Picatout/tubular-door-bell/docs/Grand_pic-f1.jpg

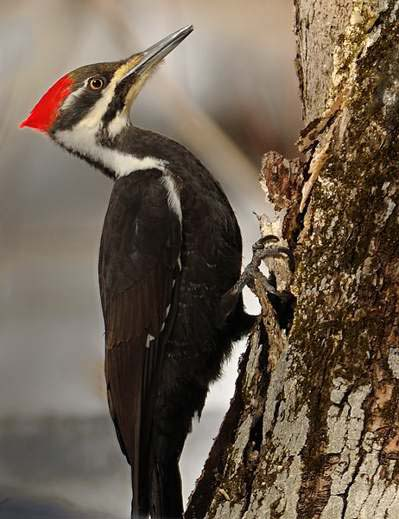
docs/Grand_pic-f1.jpg
