Picatout/tubular-door-bell/docs/DIY_Millimeters_Wind_Chime_Tube_Calculator_A440_C9_Chord.ods

Sheet: Tubing Length Calculator
Chime Length Calculator for the C-9 Chord (C E G Bb D) mm version A=440 for a Tube or Rod unrestricted at both ends
To determine the resonant frequency for a rod set the ID=0 and enter the OD and Metal Type
Enter values in BLUE, answers in ORANGE (inches) and in YELLOW (mm)
OD mm = |  | 15,312 | ID mm = |  | 12,208 | Metal = |  | Copper |  | < Click to Select
Wall = | 1,552 | mm | Length calculated for fundamental F Hang Point is for fundamental F node
Note | Freq Hz | Length inches | Hang Point | Length mm | Hang Point | Note | Freq Hz | Length inches | Hang Point | Length mm | Hang Point
C1 | 32,70 | 53 7/8 | 12 1/16 | 1368,4 | 306,8 | C5 | 523,30 | 13 1/2 | 3 | 342,9 | 76,9
E | 41,21 | 48 | 10 3/4 | 1219,2 | 273,3 | E | 659,30 | 12 | 2 11/16 | 304,8 | 68,3
G | 49,00 | 44 1/16 | 9 7/8 | 1119,2 | 250,9 | G | 784,00 | 11 | 2 7/16 | 279,4 | 62,6
A#/Bb | 58,30 | 40 3/8 | 9 1/16 | 1025,5 | 229,9 | A#/Bb | 932,30 | 10 1/8 | 2 1/4 | 257,2 | 57,7
D2 | 73,41 | 36 | 8 1/16 | 914,4 | 205,0 | D6 | 1 174,61 | 9 | 2 | 228,6 | 51,3
Total feet = |  | 18,5 | Total cm= | 564,7 |  | Total feet required |  | 4,6 | Total cm= | 141,3
C2 | 65,40 | 38 1/8 | 8 9/16 | 968,4 | 217,1 | C6 | 1 046,50 | 9 1/2 | 2 1/8 | 241,3 | 54,1
E | 82,40 | 33 15/16 | 7 5/8 | 862,0 | 193,3 | E | 1 318,50 | 8 1/2 | 1 7/8 | 215,9 | 48,4
G | 98,01 | 31 1/8 | 7 | 790,6 | 177,2 | G | 1 568,00 | 7 13/16 | 1 3/4 | 198,4 | 44,5
A#/Bb | 116,50 | 28 9/16 | 6 3/8 | 725,5 | 162,7 | A#/Bb | 1 864,60 | 7 1/8 | 1 5/8 | 181,0 | 40,6
D3 | 146,80 | 25 7/16 | 5 11/16 | 646,1 | 144,9 | D7 | 2 349,20 | 6 3/8 | 1 7/16 | 161,9 | 36,3
Total feet required |  | 13,1 | Total cm= | 399,3 |  | Total feet required |  | 3,3 | Total cm= | 99,9
C3 | 130,81 | 26 15/16 | 6 1/16 | 684,2 | 153,4 | C7 | 2 093,00 | 6 3/4 | 1 1/2 | 171,5 | 38,4
E | 164,80 | 24 | 5 3/8 | 609,6 | 136,7 | E | 2 637,00 | 6 | 1 3/8 | 152,4 | 34,2
G | 196,00 | 22 | 4 15/16 | 558,8 | 125,3 | G | 3 136,00 | 5 1/2 | 1 1/4 | 139,7 | 31,3
A#/Bb | 233,10 | 20 3/16 | 4 1/2 | 512,8 | 115,0 | A#/Bb | 3 729,20 | 5 1/16 | 1 1/8 | 128,6 | 28,8
D4 | 293,70 | 18 | 4 1/16 | 457,2 | 102,5 | D8 | 4 698,40 | 4 1/2 | 1 | 114,3 | 25,6
Total feet required |  | 9,3 | Total cm= | 282,3 |  | Total feet required |  | 2,3 | Total cm= | 70,6
C4 | 261,60 | 19 1/16 | 4 1/4 | 484,2 | 108,6
E | 329,61 | 17 | 3 13/16 | 431,8 | 96,8
G | 392,00 | 15 9/16 | 3 1/2 | 395,3 | 88,6
A#/Bb | 466,20 | 14 1/4 | 3 3/16 | 362,0 | 81,1
D5 | 587,30 | 12 3/4 | 2 7/8 | 323,9 | 72,6
Total feet required |  | 6,6 | Total cm= | 199,7
Calculate Length or Frequency for ID & OD entered above
Enter F= | 220,00 | 20 13/16 | 4 11/16 | 528,6 | 118,5 | Convert |  | 2,000 | inches to | 50,8 | mm
 |  | Enter L ↓ |  |  |  |  |  | 25,4 | mm to | 1 | inches
F= | 204,35 | 21 9/16 | 4 13/16 | 547,7 | 122,8 | http://leehite.org/Chimes.htm

Sheet: Tubing Length Ratio Calculator
Wind Chime Tubing Length Ratio Calculator
Can be used for a tube open at both ends or for a tube with end caps
 |  | by referencing a tube of known length & frequency.
Enter Values in Blue Boxes Answers in Green Boxes
Enter measured tubing length | Enter measured tubing frequency | Enter desired tubing frequency | Answer length of tubing for desired frequency | Answer Hang point for tube open at both ends
mm or Inches | Hz | Hz
18,25 | 440,0 | 392 | 19 5/16 | 4 5/16
If you have a chime tube for which you know the exact musical note or the exact frequency, you can use that tube to make other chimes in the same family of size and metal. The tube does not need to match any particular note or frequency. The important measurement is that you know the exact frequency and length. For example, say you have a 3/4" type L copper pipe that you know is tuned for A4 (440 Hz) and it's length is 18 1/4" inches, and you want a tube tuned for 392 Hz. Enter those values in the blue boxes. The green boxes provide the length for the 392 Hz chime and the hang point at 4 5/16". Repeating the process until you have determined the correct length for all the chimes in your set. You then have lengths for notes using 3/4" type L copper pipe. If you do not know the musical note or frequency for a length of tubing, use a piano or other musical instrument to determine the musical note. Maybe ask a musical friend to help out. A good piano tuning program called Tune Lab Pro works well for measuring frequency. Do not use it for measuring musical notes as it is set up for a string instrument and not for a wind chime tube, but it will tell you the fundamental frequency.
See | www.tunelab-world.com/

Sheet: DATA
February 20, 2010 | Properties Used for Calculations
Modulus of Elasticity = | 16 000 000 | psi
Density = | 0,3226 | Lbm / in3
Constants
Gravity Constant = | 386,4 | In / sec2
Euler's Constants = | βl2 | Suspension Point
1st = | 22,370 | 0,2242
2nd = | 61,670 | 0,132
3rd = | 120,900 | 0,0944
4th = | 199,859 | 0,0735
Calculate Values
Area Moment of Inertia = | 0,003863333246796 | in4
Area = | 0,103990242336149 | in2
K =√ ( E*I / (A*p) ) = | 26682,7851506265
 | Material Properties
 | Modulus of Elasticity | Density
Material | psi | Lbm / in3 | Adjust Modulus of Elasticity and Density to fit your specific material of choice.
Aluminum | 10 000 000 | 0,0980
Brass | 17 000 000 | 0,3080
Cast Iron | 13 400 000 | 0,2600
Copper | 16 000 000 | 0,3226
Steel | 30 000 000 | 0,2835
Stainless Steel | 28 300 000 | 0,2830
Titanium | 14 900 000 | 0,1630
 | Nominal Values | Nominal Values
Aluminum | 10,000,000 to 10,300,000 | 0.0925 to 0.098
Brass | 15,000,000 to 17,000,000 | 0.303 to 0.315
Cast Iron | 11,600,000 to 13,400,000 | 0.2456 to 0.2817
Copper | 16,000,000 to 17,000,000 | 0,3226
Steel | 30 000 000 | 0,2835
Stainless Steel | 28,000,000 to 29,000,000 | 0.2702 to 0.2889
Titanium | 14,500,000 to 14,900,000 | 0.162 to 0.164
All dimensions calculated are based on OD, ID in mm and Material type OD = outside dimension of tubing (mm), ID = inside dimension of tubing (mm) Material type = Aluminum, Brass, Cast Iron, Copper, Steel, Stainless Stee and Titanium Note selection by frequency in Hz. The calculator uses nominal values for material properties; however, if you know the exact material density and the exact modulus of elasticity, you can enter that data for your specific material.
Be aware that some tubing may produce a beating effect when struck. This is often due to variations in the cross section of the tubing from variations and inconsistencies in the manufacturing process. The Elasticity and the Density of the tubing will be different depending on where the tube is struck. The tube will produce two frequencies and these two frequencies will produce the beating effect. Some people enjoy this type of effect, others may find it annoying. If you want to avoid this wah-wah effect, make sure you acquire high quality tubing – or test a small piece before buying in bulk. The problem with tubing which exhibits this type of effect is that it makes precise tuning more difficult.

Sheet: Music Scale
Note | A=440 Freq Hz | 1st Overtone X 2.76 | 2nd Overtone X 5.40 | 3rd Overtone X 8.93 | 4th Overtone X 13.34 | Note | Freq Hz | 1st Overtone X 2.76 | 2nd Overtone X 5.40 | 3rd Overtone X 8.93 | 4th Overtone X 13.34
C0 | 16,40 | 45,18 | 88,56 | 146,45 | 218,78 | G | 392,00 | 1 079,96 | 2 116,80 | 3 500,56 | 5 229,28
C#/Db | 17,30 | 17,30 | 93,42 | 154,49 | 230,78 | G#/Ab | 415,30 | 1 144,15 | 2 242,62 | 3 708,63 | 5 540,10
D | 18,40 | 50,69 | 99,36 | 164,31 | 245,46 | A | 440,01 | 1 212,23 | 2 376,05 | 3 929,29 | 5 869,73
D#/Eb | 19,40 | 53,45 | 104,76 | 173,24 | 258,80 | A#/Bb | 466,20 | 1 284,38 | 2 517,48 | 4 163,17 | 6 219,11
E | 20,60 | 56,75 | 111,24 | 183,96 | 274,80 | B | 493,91 | 1 360,72 | 2 667,11 | 4 410,62 | 6 588,76
F | 21,80 | 60,06 | 117,72 | 194,67 | 290,81 | C5 | 523,30 | 1 441,69 | 2 825,82 | 4 673,07 | 6 980,82
F#/Gb | 23,10 | 63,64 | 124,74 | 206,28 | 308,15 | C#/Db | 554,40 | 1 527,37 | 2 993,76 | 4 950,79 | 7 395,70
G | 24,50 | 67,50 | 132,30 | 218,79 | 326,83 | D | 587,30 | 1 618,01 | 3 171,42 | 5 244,59 | 7 834,58
G#/Ab | 26,00 | 71,63 | 140,40 | 232,18 | 346,84 | D#/Eb | 622,30 | 1 714,44 | 3 360,42 | 5 557,14 | 8 301,48
A | 27,50 | 75,76 | 148,50 | 245,58 | 366,85 | E | 659,30 | 1 816,37 | 3 560,22 | 5 887,55 | 8 795,06
A#/Bb | 29,10 | 80,17 | 157,14 | 259,86 | 388,19 | F | 698,50 | 1 924,37 | 3 771,90 | 6 237,61 | 9 317,99
B | 30,90 | 85,13 | 166,86 | 275,94 | 412,21 | F#/Gb | 740,00 | 2 038,70 | 3 996,00 | 6 608,20 | 9 871,60
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
C4 | 261,60 | 720,71 | 1 412,64 | 2 336,09 | 3 489,74 | G | 6 272,00 | 17 279,36 | 33 868,80 | 56 008,96 | 83 668,48
C#/Db | 277,20 | 763,69 | 1 496,88 | 2 475,40 | 3 697,85 | G#/Ab | 6 644,80 | 18 306,42 | 35 881,92 | 59 338,06 | 88 641,63
D | 293,70 | 809,14 | 1 585,98 | 2 622,74 | 3 917,96 | A | 7 040,00 | 19 395,20 | 38 016,00 | 62 867,20 | 93 913,60
D#/Eb | 311,10 | 857,08 | 1 679,94 | 2 778,12 | 4 150,07 | A#/Bb | 7 458,40 | 20 547,89 | 40 275,36 | 66 603,51 | 99 495,06
E | 329,61 | 908,08 | 1 779,89 | 2 943,42 | 4 397,00 | B | 7 902,01 | 21 770,04 | 42 670,85 | 70 564,95 | 105 412,81
F | 349,30 | 962,32 | 1 886,22 | 3 119,25 | 4 659,66 | C9 | 8 367,01 | 23 051,11 | 45 181,85 | 74 717,40 | 111 615,91
F#/Gb | 370,00 | 1 019,35 | 1 998,00 | 3 304,10 | 4 935,80

Sheet: Aluminum
Standard Dimension Tables for Aluminum Tubing (inches)
Tubing Gauge | 22 | 20 | 18 | 17 | 16 | 14 | 12
Wall Thickness | 0,028 | 0,035 | 0,049 | 0,058 | 0,065 | 0,083 | 0,109
* These sizes are extruded; all other sizes are drawn tubes.
OD inches | ID inches | Wall inches | OD inches | ID inches | Wall inches | OD inches | ID inches | Wall inches
0,500 | 0,444 | 0,028 | 1,000 | 0,930 | 0,035 | 1,625 | 1,555 | 0,035
 | 0,430 | 0,035 |  | 0,902 | 0,049 |  | 1,509 | 0,058
 | 0,402 | 0,049 |  | 0,884 | 0,058 | 1,750 | 1,634 | 0,058
 | 0,384 | 0,058 |  | 0,870 | 0,065 |  | 1,584 | 0,083
 | 0,370 | 0,065 |  | 0,834 | 0,083 | 1,875 | 1,759 | 0,508
0,625 | 0,569 | 0,028 | 1,125 | 1,055 | 0,035 | 2,000 | 1,902 | 0,049
 | 0,555 | 0,035 |  | 1,009 | 0,058 |  | 1,870 | 0,065
 | 0,527 | 0,049 | 1,250 | 1,180 | 0,035 |  | 1,834 | 0,083
 | 0,509 | 0,058 |  | 1,152 | 0,049 |  | 1,750 | *0.125
 | 0,495 | 0,065 |  | 1,134 | 0,058 |  | 1,500 | *0.250
0,750 | 0,680 | 0,035 |  | 1,120 | 0,065 | 2,250 | 2,152 | 0,049
 | 0,652 | 0,049 |  | 1,084 | 0,083 |  | 2,120 | 0,065
 | 0,634 | 0,058 | 1,375 | 1,305 | 0,035 |  | 2,084 | 0,083
 | 0,620 | 0,065 |  | 1,259 | 0,058 | 2,500 | 2,370 | 0,065
 | 0,584 | 0,083 | 1,500 | 1,430 | 0,035 |  | 2,334 | 0,083
0,875 | 0,805 | 0,035 |  | 1,402 | 0,049 |  | 2,250 | *0.125
 | 0,777 | 0,049 |  | 1,384 | 0,058 |  | 2,000 | *0.250
 | 0,759 | 0,058 |  | 1,370 | 0,065 | 3,000 | 2,870 | 0,065
 | 0,745 | 0,065 |  | 1,334 | 0,083 |  | 2,750 | *0.125
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
 |  |  | 5" OD x 0.25" WALL x 4.5" ID
 |  |  | 6" OD x 0.125" WALL x 5.75" ID
 |  |  | 6" OD x 0.1875" WALL x 5.625" ID
 |  |  | 7" OD x 0.125" WALL x 6.75" ID
 |  |  | 8" OD x 0.125" WALL x 7.75" ID
 |  |  | 8" OD x 0.25" WALL x 7.5" ID
 |  |  | 8" OD x 0.5" WALL x 7" ID

Sheet: Brass
Standard Dimension Tables for Brass
Available sizes for Tube Brass | Available sizes for BRASS TUBE
1/2" OD {A} x 0.436" ID {B} x .032" Wall | 0.5" OD x 0.03" WALL x 0.44" ID
1/2" OD {A} x 0.370" ID {B} x .065" Wall | 0.5" OD x 0.042" WALL x 0.416" ID
5/8" OD {A} x 0.561" ID {B} x .032" Wall | 0.5" OD x 0.065" WALL x 0.37" ID
5/8" OD {A} x 0.495" ID {B} x .065" Wall | 0.625" OD x 0.029" WALL x 0.567" ID
3/4" OD {A} x 0.686" ID {B} x .032" Wall | 0.625" OD x 0.065" WALL x 0.495" ID
3/4" OD {A} x 0.620" ID {B} x .065" Wall | 0.75" OD x 0.029" WALL x 0.692" ID
1" OD {A} x 0.870" ID {B} x .065" Wall | 0.75" OD x 0.04" WALL x 0.67" ID
1-1/4" OD {A} x 1.120" ID {B} x .065" Wall | 0.75" OD x 0.065" WALL x 0.62" ID C330 TUBE
1-1/2" OD {A} x 1.370" ID {B} x .065" Wall | 0.75" OD x 0.12" WALL x 0.51" ID
1-1/2" OD {A} x 1.250" ID {B} x .125" Wall | 0.875" OD x 0.03" WALL x 0.815" ID
1-5/8" OD {A} x 1.375" ID {B} x .125" Wall | 0.875" OD x 0.065" WALL x 0.745" ID
1-3/4" OD {A} x 1.620" ID {B} x .065" Wall | 1" OD x 0.03" WALL x 0.94" ID
2" OD {A} x 1.870" ID {B} x .065" Wall | 1" OD x 0.065" WALL x 0.87" ID
2-1/4" OD {A} x 2.120" ID {B} x .065" Wall | 1.25" OD x 0.04" WALL x 1.17" ID
 | 1.25" OD x 0.065" WALL x 1.12" ID
 | 1.5" OD x 0.04" WALL x 1.42" ID
 | 1.5" OD x 0.065" WALL x 1.37" ID
 | 1.75" OD x 0.065" WALL x 1.62" ID
 | 1.75" OD x 0.12" WALL x 1.51" ID
 | 2" OD x 0.049" WALL x 1.902" ID
 | 2" OD x 0.065" WALL x 1.87" ID
 | 2" OD x 0.109" WALL x 1.782" ID
 | 2" OD x 0.12" WALL x 1.76" ID
 | 2.5" OD x 0.065" WALL x 2.37" ID
 | 3" OD x 0.049" WALL x 2.902" ID
 | 3" OD x 0.065" WALL x 2.87" ID
 | 4" OD x 0.065" WALL x 3.87" ID C330 TUBE

Sheet: Copper
Standard Dimension Tables for Copper Tubing
Wall thickness of copper pipe varies with the pipe schedule. The four common standards are named K (Thick-Walled), L (Medium-Walled), M (Thin-Wall), and DWV (Drain/Waste/Vent - non-pressurized) The printing on the pipe is color coded for identification; K is Green, L is Blue, M is Red, and DWV is Yellow. Both type "M" & type "L" can be found in home plumbing at Home Depot & Lowes.
Nominal | Actual O.D. | I.D. |  |  |  | Wall Thickness
Pipe Size |  | K | L | M | DWV | K | L | M | DWV
1/2" | 0,625 | 0,527 | 0,545 | 0,569 | - | 0,049 | 0,04 | 0,028 | -
5/8" | 0,750 | 0,652 | 0,666 | - | - | 0,049 | 0,042 | - | -
3/4" | 0,875 | 0,745 | 0,785 | 0,811 | - | 0,065 | 0,045 | 0,032 | -
1" | 1,125 | 0,995 | 1,025 | 1,055 | - | 0,065 | 0,05 | 0,035 | -
1-1/4" | 1,375 | 1,245 | 1,265 | 1,291 | 1,295 | 0,065 | 0,055 | 0,042 | 0,04
1-1/2" | 1,625 | 1,481 | 1,505 | 1,527 | 1,541 | 0,072 | 0,06 | 0,049 | 0,042
2" | 2,125 | 1,959 | 1,985 | 2,009 | 2,041 | 0,083 | 0,07 | 0,058 | 0,042
2-1/2" | 2,625 | 2,435 | 2,465 | 2,495 | - | 0,095 | 0,08 | 0,065 | -
3" | 3,125 | 2,907 | 2,945 | 2,981 | 3,03 | 0,109 | 0,09 | 0,072 | 0,045
3 1/2 | 3,625 | 3,385 | 3,425 | 3,259 |  | 0,12 | 0,1 | 0,083
4 | 4,125 | 3,857 | 3,897 | 3,707 |  | 0,134 | 0,114 | 0,095
5 | 5,125 | 4,805 | 4,875 | 4,657 |  | 0,16 | 0,125 | 0,109
6 | 6,125 | 5,741 | 5,845 | 5,601 |  | 0,192 | 0,14 | 0,122
Available sizes for |  |  |  |  | Available sizes for
C101 H04 (FULL HARD) TUBE |  |  |  |  | C122 HARD DRAWN TUBE
0.5" OD x 0.035" WALL x 0.43" ID |  |  |  |  | 0.5" OD x 0.032" WALL x 0.436" ID
0.5" OD x 0.0625" WALL x 0.375" ID |  |  |  |  | 0.5" OD x 0.065" WALL x 0.37" ID
0.5" OD x 0.125" WALL x 0.25" ID |  |  |  |  | 0.625" OD x 0.065" WALL x 0.495" ID
0.625" OD x 0.121" WALL x 0.383" ID |  |  |  |  | 0.75" OD x 0.065" WALL x 0.62" ID
0.75" OD x 0.035" WALL x 0.68" ID |  |  |  |  | 0.875" OD x 0.065" WALL x 0.745" ID
0.75" OD x 0.0625" WALL x 0.625" ID |  |  |  |  | 1" OD x 0.065" WALL x 0.87" ID
0.75" OD x 0.125" WALL x 0.5" ID |  |  |  |  | 1.25" OD x 0.065" WALL x 1.12" ID
1" OD x 0.125" WALL x 0.75" ID |  |  |  |  | 1.5" OD x 0.065" WALL x 1.37" ID
1" OD x 0.25" WALL x 0.5" ID |  |  |  |  | 2" OD x 0.065" WALL x 1.87" ID
1.25" OD x 0.125" WALL x 1" ID
1.5" OD x 0.125" WALL x 1.25" ID
1.5" OD x 0.25" WALL x 1" ID
1.5" OD x 0.375" WALL x 0.75" ID
1.625" OD x 0.049" WALL x 1.527" ID
1.75" OD x 0.065" WALL x 1.62" ID
1.75" OD x 0.375" WALL x 1" ID
2" OD x 0.063" WALL x 1.874" ID
2" OD x 0.125" WALL x 1.75" ID
2.125" OD x 0.25" WALL x 1.625" ID
2.25" OD x 0.3125" WALL x 1.625" ID
2.5" OD x 0.065" WALL x 2.37" ID
2.5" OD x 0.25" WALL x 2" ID
2.5" OD x 0.375" WALL x 1.75" ID
2.75" OD x 0.25" WALL x 2.25" ID
2.75" OD x 0.375" WALL x 2" ID
2.75" OD x 0.625" WALL x 1.5" ID
3" OD x 0.25" WALL x 2.5" ID
3" OD x 0.625" WALL x 1.75" ID
3.5" OD x 0.062" WALL x 3.376" ID
3.5" OD x 0.187" WALL x 3.126" ID
3.5" OD x 0.25" WALL x 3" ID
3.5" OD x 0.562" WALL x 2.376" ID
3.75" OD x 0.5" WALL x 2.75" ID
4" OD x 0.25" WALL x 3.5" ID
4" OD x 0.5" WALL x 3" ID
4" OD x 0.625" WALL x 2.75" ID
4.5" OD x 0.109" WALL x 4.282" ID
6.5" OD x 0.5" WALL x 5.5" ID
7.5" OD x 0.125" WALL x 7.25" ID

Sheet: Iron
Standard Dimension Tables for Iron
Pipe is specified by a nominal dimension which bears little or no resemblance to the actual dimensions of the pipe.
Wrought Iron Pipe (Schedule 40) is used for water supply in older houses. It comes either black or galvanized. Joints are made by threading pipe into cast iron fittings
Nominal Pipe Size inches | O.D. | I.D. | Wall
 |  |  | Thickness
1 | 1,315 | 1,049 | 0,133
1,250 | 1,660 | 1,380 | 0,140
1,500 | 1,900 | 1,610 | 0,145
2 | 2,375 | 2,067 | 0,154
2,500 | 2,875 | 2,468 | 0,204
Cast Iron Pipe is typically used for sewer lines and municipal water. It comes in eight classes, A through H, rated by pressure in increments of 100 feet of head.
Nominal Pipe Size inches | Class A 100 Foot Head 43 psi |  |  | Class B 200 Foot Head 86 psi
 | O.D. | I.D. | Wall | O.D. | I.D. | Wall
 |  |  | Thickness |  |  | Thickness
3 | 3,800 | 3,020 | 0,390 | 3,960 | 3,120 | 0,420
4 | 4,800 | 3,960 | 0,420 | 5,000 | 4,100 | 0,450
6 | 6,900 | 6,020 | 0,440 | 7,100 | 6,140 | 0,480
8 | 9,050 | 8,130 | 0,460 | 9,050 | 8,030 | 0,510
10 | 11,100 | 10,100 | 0,500 | 11,100 | 9,960 | 0,570

Sheet: Steel
Standard Dimension Tables for EMT, Cold Rolled & Stainless Steel
Electrical Metallic Tubing (EMT)
aka "thin-wall conduit"
EMT | Actual
Nominal inches | OD inches | ID inches | Wall Thickness | Gauge
3/8 | 0,577 | 0,493 | 0,042 | 19
1/2 | 0,706 | 0,622 | 0,042 | 19
3/4 | 0,922 | 0,824 | 0,049 | 18
1 | 1,163 | 1,049 | 0,057 | 17
1 1/4 | 1,510 | 1,380 | 0,065 | 16
1 1/2 | 1,740 | 1,610 | 0,065 | 16
2 | 2,197 | 2,067 | 0,065 | 16
2 1/2 | 2.875 | 2,731 | 0,072 | 15
3 | 3.500 | 3,356 | 0,072 | 15
3 1/2 | 4.000 | 3,834 | 0,083 | 14
4 | 4.500 | 4,334 | 0,083 | 14
Scroll down for available sizes for
Cold Rolled and Stainless
A513 - TYPE 5 STEEL TUBE DOM Cold Rolled
0.5" OD x 0.035" WALL x 0.43" ID
0.5" OD x 0.049" WALL x 0.4" ID
0.5" OD x 0.065" WALL x 0.37" ID
0.5" OD x 0.095" WALL x 0.31" ID
0.5" OD x 0.12" WALL x 0.26" ID
0.625" OD x 0.058" WALL x 0.509" ID
0.625" OD x 0.065" WALL x 0.5" ID
0.625" OD x 0.083" WALL x 0.459" ID
0.625" OD x 0.095" WALL x 0.435" ID
0.625" OD x 0.12" WALL x 0.39" ID
0.75" OD x 0.035" WALL x 0.68" ID
0.75" OD x 0.049" WALL x 0.652" ID
0.75" OD x 0.065" WALL x 0.62" ID
0.75" OD x 0.083" WALL x 0.58" ID
0.75" OD x 0.095" WALL x 0.56" ID
0.75" OD x 0.109" WALL x 0.53" ID
0.75" OD x 0.12" WALL x 0.51" ID
0.75" OD x 0.156" WALL x 0.438" ID
0.75" OD x 0.188" WALL x 0.37" ID
0.875" OD x 0.049" WALL x 0.78" ID
0.875" OD x 0.065" WALL x 0.75" ID
0.875" OD x 0.083" WALL x 0.71" ID
0.875" OD x 0.095" WALL x 0.685" ID
0.875" OD x 0.109" WALL x 0.657" ID
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
2" OD x 0.134" WALL x 1.732" ID
2" OD x 0.156" WALL x 1.688" ID
2" OD x 0.188" WALL x 1.624" ID
2" OD x 0.25" WALL x 1.5" ID
2.5" OD x 0.065" WALL x 2.37" ID
2.5" OD x 0.12" WALL x 2.26" ID
2.5" OD x 0.188" WALL x 2.124" ID
3" OD x 0.065" WALL x 2.87" ID
3" OD x 0.188" WALL x 2.624" ID

Sheet: Material Properties
Material Properties for Aluminum, Brass, Copper, Cold Rolled Steel & Stainless Steel
Aluminum 2024-T3
Minimum Properties | Ultimate Tensile Strength, psi | 70 000
 | Yield Strength, psi | 50 000
 | Brinell Hardness | 120
 | Rockwell Hardness | B75
Chemistry | Aluminum (Al) | 90.7 - 94.7%
 | Chromium (Cr) | 0.1% max
 | Copper (Cu) | 3.8 - 4.9%
 | Iron (Fe) | 0.5% max
 | Magnesium (Mg) | 1.2 - 1.8%
 | Manganese (Mn) | 0.3 - 0.9%
 | Silicon (Si) | 0.5% max
Aluminum 6061-T6
Physical and Mechanical Properties | Ultimate Tensile Strength, psi | 45 000
 | Yield Strength, psi | 40 000
 | Brinell Hardness | 95
 | Rockwell Hardness | B60
Chemistry | Aluminum (Al) | 95.8 - 98.6%
 | Chromium (Cr) | 0.04 - 0.35%
 | Copper (Cu) | 0.15 - 0.40%
 | Iron (Fe) | 0,70 %
 | Magnesium (Mg) | 0.8 - 1.2%
 | Manganese (Mn) | 0.15% max
 | Silicon (Si) | 0.4 - 0.8%
 | Zinc (Zn) | 0,25 %
Aluminum 6063-T52
Minimum Properties | Ultimate Tensile Strength, psi | 27 000
 | Yield Strength, psi | 21 000
 | Brinell Hardness | 60
Chemistry | Aluminum (Al) | 97.5% max
 | Chromium (Cr) | 0.1% max
 | Copper (Cu) | 0.1% max
 | Iron (Fe) | 0.35% max
 | Magnesium (Mg) | 0.45 - 0.90%
 | Manganese (Mn) | 0.1% max
 | Silicon (Si) | 0.2 - 0.6%
Brass C330
Minimum Properties | Ultimate Tensile Strength, psi | 65 300
 | Yield Strength, psi | 50 000
 | Elongation | 32 %
 | Rockwell Hardness | B70
Chemistry | Copper (Cu) | 65 - 68%
 | Zinc (Zn) | 33,50 %
 | Iron (Fe) | 0.07% max
 | Lead (Pb) | 0.2 - 0.8%
Copper C101 Oxygen Free Electronic Copper - Half Hard (H02) Temper
Physical and Mechanical Properties | Ultimate Tensile Strength, psi | 43 500
 | Yield Strength, psi | 36 300
 | Rockwell Hardness | B40
 | Machinability | 20% of free-cutting brass rod (C360)
Copper C122
Physical and Mechanical Properties | Ultimate Tensile Strength, psi | 32 000
 | Yield Strength, psi | 10 000
 | Machinability | 20% of free-cutting brass rod (C360)
Chemistry | Copper (Cu) | 99,90 %
 | Phosphorus (P) | 0.02% max
Stainless Steel 304 (annealed condition)
Minimum Properties | Ultimate Tensile Strength, psi | 73 200
 | Yield Strength, psi | 31 200
 | Elongation | 70 %
 | Rockwell Hardness | B70
Chemistry | Iron (Fe) | 66.5 - 74%
 | Carbon (C) | 0.08% max
 | Chrome (Cr) | 18 - 20%
 | Manganese (Mn) | 2% max
 | Nickel (Ni) | 8 - 10.5%
 | Phosphorus (P) | 0.045% max
 | Sulphur (S) | 0.03% max
 | Silicon (Si) | 1% max
Stainless Steel 316 (annealed condition)
Minimum Properties | Ultimate Tensile Strength, psi | 89 900
 | Yield Strength, psi | 60 200
 | Elongation | 45 %
 | Rockwell Hardness | B91
Chemistry | Iron (Fe) | 65 %
 | Carbon (C) | 0.08% max
 | Chrome (Cr) | 17 %
 | Manganese (Mn) | 2 %
 | Molybdenum (Mo) | 2,50 %
 | Nickel (Ni) | 12 %
 | Phosphorus (P) | 0,05 %
 | Sulphur (S) | 0.03% min
 | Silicon (Si) | 1 %
Steel Cold Rolled ASTM A513 alloys 1020 - 1026 Mild (low-carbon)
Minimum Properties | Ultimate Tensile Strength, psi | 87 000
 | Yield Strength, psi | 72 000
 | Elongation | 10,00 %
 | Rockwell Hardness | B89
Chemistry | Iron (Fe) | 99.08 - 99.53%
 | Carbon (C) | 0.18 - 0.23%
 | Manganese (Mn) | 0.3 - 0.6%
 | Phosphorus (P) | 0.04% max
 | Sulfur (S) | 0.05% max
