Picatout/tubular-door-bell/docs/vue-complète-assemblage.jpg

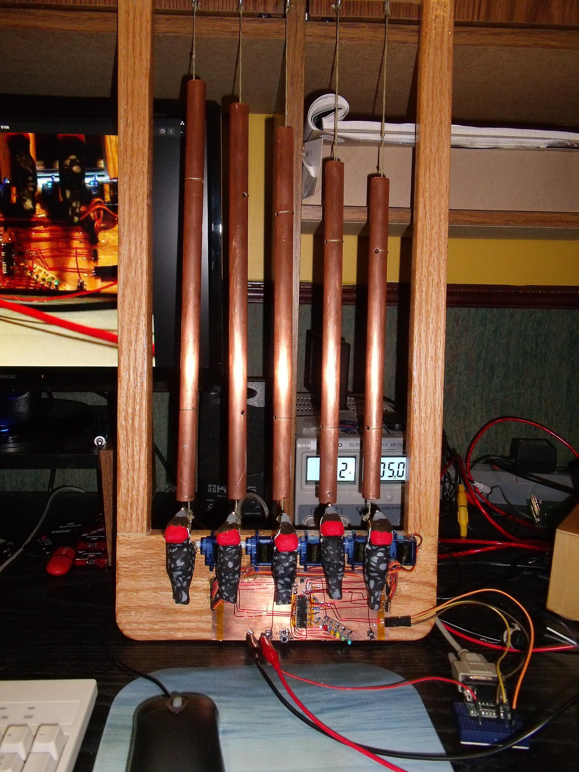
docs/vue-complète-assemblage.jpg
