Picatout/tubular-door-bell/docs/schematic.pdf

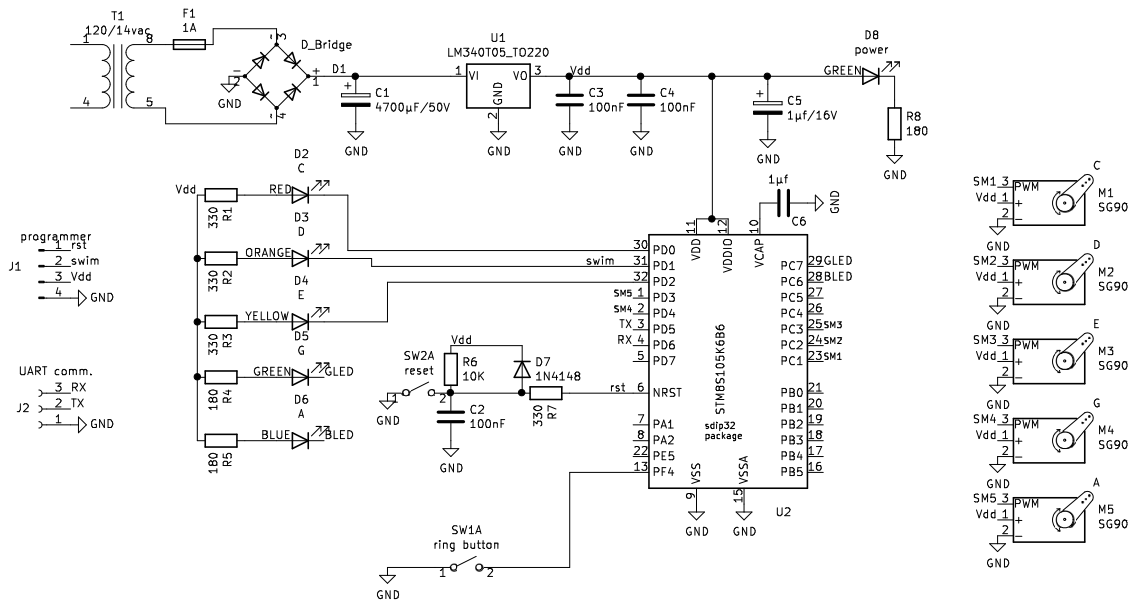
[picture p8: page 1]
