Picatout/tubular-door-bell/(commit log)

2020-08-31 ajouts fichier excell
    ajout des fichier de Lee Hite
    [DIY_Millimeters_Wind_Chime_Tube_Calculator_A440_C9_Chord.ods, DIY_Millimeters_Wind_Chime_Tube_Calculator_A=440_Pentatonic_Scale.ods]
2020-08-31 modifié readme
    Ajout de liens dans le readme
2020-08-31 Create SG-90-servo-motor.pdf
    added SG-90-servo-motor.pdf to docs
2020-08-31 mise à jour readme.md
    ajout de l'information sur le travail fait aujourd'hui.
2020-09-02 ajout schématique
    [door-bell.kicad_pcb, door-bell.sch]
2020-09-03 Modification au circuit pour ajouter une LED pour chaque note.
    [door-bell.sch]
2020-09-05 servo-motor test
2020-09-07 modification au concept ajout du dessin de la révision
2020-09-10 complété assemblage mécanique mise à jour readme.
2020-09-11 mise à jour schématique
    [door-bell.sch]
2020-09-12 débuté assemblage électronique programmation de stm8_eForth sur mcu stm8s105k6b6
    [door-bell.sch]
2020-09-15 Travail sur l'assemblage électronque travail sur l'application en forth dans le fichier doorbell.f
    [door-bell.sch]
2020-09-19 Travail sur sous-module SendFile Travail sur doorbell.f monté plaquette circuit sur cadre test application
    [door-bell.sch]
